Fcr09/CPU_MIPS/fpga_single_cycle/fpga_single_cycle.runs/impl_1/usage_statistics_webtalk.html

### Device Usage Page (usage_statistics_webtalk.html)

This HTML page displays the device usage statistics that will be sent to Xilinx.
To see the actual file transmitted to Xilinx, please click here.

software_version_and_target_device
beta | FALSE | build_version | 3064766
date_generated | Mon Sep 12 18:46:56 2022 | os_platform | WIN64
product_version | Vivado v2020.2 (64-bit) | project_id | 06335934545b4817ba23d04142ba414c
project_iteration | 2 | random_id | 32a24ede3cdd5bcc840593bf387105b8
registration_id | 32a24ede3cdd5bcc840593bf387105b8 | route_design | TRUE
target_device | xc7a100t | target_family | artix7
target_package | csg324 | target_speed | -1
tool_flow | Vivado

user_environment
cpu_name | Intel(R) Core(TM) i7-10510U CPU @ 1.80GHz | cpu_speed | 2304 MHz
os_name | Windows Server 2016 or Windows 10 | os_release | major release (build 9200)
system_ram | 17.000 GB | total_processors | 1

vivado_usage

gui_handlers
basedialog_cancel=1 | basedialog_ok=18 | exploreaheadview_launch_selected_runs=2 | expruntreepanel_exp_run_tree_table=4
filesetpanel_file_set_panel_tree=15 | flownavigatortreepanel_flow_navigator_tree=12 | htree_collapse_all=1 | msgview_information_messages=1
netlisttreeview_netlist_tree=24 | pacommandnames_auto_connect_target=2 | pacommandnames_run_bitgen=2 | pacommandnames_schematic=4
pacommandnames_select_area=1 | pacommandnames_simulation_live_run=2 | pacommandnames_simulation_run_behavioral=1 | pacommandnames_zoom_fit=1
paviews_device=1 | paviews_project_summary=3 | paviews_schematic=2 | programdebugtab_open_target=2
programdebugtab_program_device=3 | programdebugtab_refresh_device=1 | programfpgadialog_program=3 | progressdialog_cancel=1
projecttab_close_design=1 | rdiviews_waveform_viewer=1 | syntheticagettingstartedview_recent_projects=1 | syntheticastatemonitor_cancel=2

taskbanner_close=3

java_command_handlers
autoconnecttarget=2 | launchprogramfpga=3 | openhardwaremanager=2 | refreshdevice=1
runbitgen=2 | runimplementation=3 | runschematic=6 | runsynthesis=5
simulationrun=1 | simulationrunfortime=2 | toggleselectareamode=1 | viewtasksynthesis=1

zoomfit=1

other_data

guimode=1

project_data
constraintsetcount=1 | core_container=false | currentimplrun=impl_1 | currentsynthesisrun=synth_1
default_library=xil_defaultlib | designmode=RTL | export_simulation_activehdl=0 | export_simulation_ies=0
export_simulation_modelsim=0 | export_simulation_questa=0 | export_simulation_riviera=0 | export_simulation_vcs=0
export_simulation_xsim=0 | implstrategy=Vivado Implementation Defaults | launch_simulation_activehdl=0 | launch_simulation_ies=0
launch_simulation_modelsim=0 | launch_simulation_questa=0 | launch_simulation_riviera=0 | launch_simulation_vcs=0
launch_simulation_xsim=74 | simulator_language=Verilog | srcsetcount=33 | synthesisstrategy=Vivado Synthesis Defaults
target_language=Verilog | target_simulator=XSim | totalimplruns=1 | totalsynthesisruns=1

unisim_transformation

post_unisim_transformation
bufg=2 | carry4=391 | dsp48e1=3 | fdce=64
fdre=32841 | gnd=11 | ibuf=3 | lut1=106
lut2=762 | lut3=7969 | lut4=3082 | lut5=2047
lut6=50243 | muxf7=4414 | muxf8=2185 | obuf=16
ramd32=72 | rams32=24 | vcc=7

pre_unisim_transformation
bufg=2 | carry4=391 | dsp48e1=3 | fdce=64
fdre=32841 | gnd=11 | ibuf=3 | lut1=106
lut2=762 | lut3=7969 | lut4=3082 | lut5=2047
lut6=50243 | muxf7=4414 | muxf8=2185 | obuf=16
ram32m=12 | vcc=7

phys_opt_design_post_place

command_line_options
-aggressive_hold_fix=default::[not_specified] | -bram_register_opt=default::[not_specified] | -clock_opt=default::[not_specified] | -critical_cell_opt=default::[not_specified]
-critical_pin_opt=default::[not_specified] | -directive=default::[not_specified] | -dsp_register_opt=default::[not_specified] | -effort_level=default::[not_specified]
-fanout_opt=default::[not_specified] | -hold_fix=default::[not_specified] | -insert_negative_edge_ffs=default::[not_specified] | -multi_clock_opt=default::[not_specified]
-placement_opt=default::[not_specified] | -restruct_opt=default::[not_specified] | -retime=default::[not_specified] | -rewire=default::[not_specified]
-shift_register_opt=default::[not_specified] | -uram_register_opt=default::[not_specified] | -verbose=default::[not_specified] | -vhfn=default::[not_specified]

report_drc

command_line_options
-append=default::[not_specified] | -checks=default::[not_specified] | -fail_on=default::[not_specified] | -force=default::[not_specified]
-format=default::[not_specified] | -internal=default::[not_specified] | -internal_only=default::[not_specified] | -max_msgs_per_check=default::[not_specified]
-messages=default::[not_specified] | -name=default::[not_specified] | -no_waivers=default::[not_specified] | -return_string=default::[not_specified]
-ruledecks=default::[not_specified] | -upgrade_cw=default::[not_specified] | -waived=default::[not_specified]

results
cfgbvs-1=1 | dpip-1=6 | dpop-1=3 | dpop-2=3

report_utilization

clocking
bufgctrl_available=32 | bufgctrl_fixed=0 | bufgctrl_used=3 | bufgctrl_util_percentage=9.38
bufhce_available=96 | bufhce_fixed=0 | bufhce_used=0 | bufhce_util_percentage=0.00
bufio_available=24 | bufio_fixed=0 | bufio_used=0 | bufio_util_percentage=0.00
bufmrce_available=12 | bufmrce_fixed=0 | bufmrce_used=0 | bufmrce_util_percentage=0.00
bufr_available=24 | bufr_fixed=0 | bufr_used=0 | bufr_util_percentage=0.00
mmcme2_adv_available=6 | mmcme2_adv_fixed=0 | mmcme2_adv_used=0 | mmcme2_adv_util_percentage=0.00
plle2_adv_available=6 | plle2_adv_fixed=0 | plle2_adv_used=0 | plle2_adv_util_percentage=0.00

dsp
dsp48e1_only_used=3 | dsps_available=240 | dsps_fixed=0 | dsps_used=3

dsps_util_percentage=1.25

io_standard
blvds_25=0 | diff_hstl_i=0 | diff_hstl_i_18=0 | diff_hstl_ii=0
diff_hstl_ii_18=0 | diff_hsul_12=0 | diff_mobile_ddr=0 | diff_sstl135=0
diff_sstl135_r=0 | diff_sstl15=0 | diff_sstl15_r=0 | diff_sstl18_i=0
diff_sstl18_ii=0 | hstl_i=0 | hstl_i_18=0 | hstl_ii=0
hstl_ii_18=0 | hsul_12=0 | lvcmos12=0 | lvcmos15=0
lvcmos18=0 | lvcmos25=0 | lvcmos33=1 | lvds_25=0
lvttl=0 | mini_lvds_25=0 | mobile_ddr=0 | pci33_3=0
ppds_25=0 | rsds_25=0 | sstl135=0 | sstl135_r=0
sstl15=0 | sstl15_r=0 | sstl18_i=0 | sstl18_ii=0

tmds_33=0

memory
block_ram_tile_available=135 | block_ram_tile_fixed=0 | block_ram_tile_used=0 | block_ram_tile_util_percentage=0.00
ramb18_available=270 | ramb18_fixed=0 | ramb18_used=0 | ramb18_util_percentage=0.00
ramb36_fifo_available=135 | ramb36_fifo_fixed=0 | ramb36_fifo_used=0 | ramb36_fifo_util_percentage=0.00

primitives
bufg_functional_category=Clock | bufg_used=3 | carry4_functional_category=CarryLogic | carry4_used=391
dsp48e1_functional_category=Block Arithmetic | dsp48e1_used=3 | fdce_functional_category=Flop & Latch | fdce_used=64
fdre_functional_category=Flop & Latch | fdre_used=32841 | ibuf_functional_category=IO | ibuf_used=3
lut1_functional_category=LUT | lut1_used=102 | lut2_functional_category=LUT | lut2_used=762
lut3_functional_category=LUT | lut3_used=7968 | lut4_functional_category=LUT | lut4_used=3082
lut5_functional_category=LUT | lut5_used=2047 | lut6_functional_category=LUT | lut6_used=50243
muxf7_functional_category=MuxFx | muxf7_used=4414 | muxf8_functional_category=MuxFx | muxf8_used=2185
obuf_functional_category=IO | obuf_used=16 | ramd32_functional_category=Distributed Memory | ramd32_used=72
rams32_functional_category=Distributed Memory | rams32_used=24

slice_logic
f7_muxes_available=31700 | f7_muxes_fixed=0 | f7_muxes_used=4414 | f7_muxes_util_percentage=13.92
f8_muxes_available=15850 | f8_muxes_fixed=0 | f8_muxes_used=2185 | f8_muxes_util_percentage=13.79
lut_as_distributed_ram_fixed=0 | lut_as_distributed_ram_used=48 | lut_as_logic_available=63400 | lut_as_logic_fixed=0
lut_as_logic_used=58330 | lut_as_logic_util_percentage=92.00 | lut_as_memory_available=19000 | lut_as_memory_fixed=0
lut_as_memory_used=48 | lut_as_memory_util_percentage=0.25 | lut_as_shift_register_fixed=0 | lut_as_shift_register_used=0
register_as_flip_flop_available=126800 | register_as_flip_flop_fixed=0 | register_as_flip_flop_used=32905 | register_as_flip_flop_util_percentage=25.95
register_as_latch_available=126800 | register_as_latch_fixed=0 | register_as_latch_used=0 | register_as_latch_util_percentage=0.00
slice_luts_available=63400 | slice_luts_fixed=0 | slice_luts_used=58378 | slice_luts_util_percentage=92.08
slice_registers_available=126800 | slice_registers_fixed=0 | slice_registers_used=32905 | slice_registers_util_percentage=25.95
lut_as_distributed_ram_fixed=0 | lut_as_distributed_ram_used=48 | lut_as_logic_available=63400 | lut_as_logic_fixed=0
lut_as_logic_used=58330 | lut_as_logic_util_percentage=92.00 | lut_as_memory_available=19000 | lut_as_memory_fixed=0
lut_as_memory_used=48 | lut_as_memory_util_percentage=0.25 | lut_as_shift_register_fixed=0 | lut_as_shift_register_used=0
lut_in_front_of_the_register_is_unused_fixed=0 | lut_in_front_of_the_register_is_unused_used=9 | lut_in_front_of_the_register_is_used_fixed=9 | lut_in_front_of_the_register_is_used_used=27
register_driven_from_outside_the_slice_fixed=27 | register_driven_from_outside_the_slice_used=36 | register_driven_from_within_the_slice_fixed=36 | register_driven_from_within_the_slice_used=32869
slice_available=15850 | slice_fixed=0 | slice_registers_available=126800 | slice_registers_fixed=0
slice_registers_used=32905 | slice_registers_util_percentage=25.95 | slice_used=15719 | slice_util_percentage=99.17
slicel_fixed=0 | slicel_used=10995 | slicem_fixed=0 | slicem_used=4724
unique_control_sets_available=15850 | unique_control_sets_fixed=15850 | unique_control_sets_used=8 | unique_control_sets_util_percentage=0.05
using_o5_and_o6_fixed=0.05 | using_o5_and_o6_used=48 | using_o5_output_only_fixed=48 | using_o5_output_only_used=0
using_o6_output_only_fixed=0 | using_o6_output_only_used=0

specific_feature
bscane2_available=4 | bscane2_fixed=0 | bscane2_used=0 | bscane2_util_percentage=0.00
capturee2_available=1 | capturee2_fixed=0 | capturee2_used=0 | capturee2_util_percentage=0.00
dna_port_available=1 | dna_port_fixed=0 | dna_port_used=0 | dna_port_util_percentage=0.00
efuse_usr_available=1 | efuse_usr_fixed=0 | efuse_usr_used=0 | efuse_usr_util_percentage=0.00
frame_ecce2_available=1 | frame_ecce2_fixed=0 | frame_ecce2_used=0 | frame_ecce2_util_percentage=0.00
icape2_available=2 | icape2_fixed=0 | icape2_used=0 | icape2_util_percentage=0.00
pcie_2_1_available=1 | pcie_2_1_fixed=0 | pcie_2_1_used=0 | pcie_2_1_util_percentage=0.00
startupe2_available=1 | startupe2_fixed=0 | startupe2_used=0 | startupe2_util_percentage=0.00
xadc_available=1 | xadc_fixed=0 | xadc_used=0 | xadc_util_percentage=0.00

synthesis

command_line_options
-assert=default::[not_specified] | -bufg=default::12 | -cascade_dsp=default::auto | -constrset=default::[not_specified]
-control_set_opt_threshold=default::auto | -debug_log=default::[not_specified] | -directive=default::default | -fanout_limit=default::10000
-flatten_hierarchy=default::rebuilt | -fsm_extraction=default::auto | -gated_clock_conversion=default::off | -generic=default::[not_specified]
-include_dirs=default::[not_specified] | -keep_equivalent_registers=default::[not_specified] | -lint=default::[not_specified] | -max_bram=default::-1
-max_bram_cascade_height=default::-1 | -max_dsp=default::-1 | -max_uram=default::-1 | -max_uram_cascade_height=default::-1
-mode=default::default | -name=default::[not_specified] | -no_lc=default::[not_specified] | -no_srlextract=default::[not_specified]
-no_timing_driven=default::[not_specified] | -os=default::[not_specified] | -part=xc7a100tcsg324-1 | -resource_sharing=default::auto
-retiming=default::[not_specified] | -rtl=default::[not_specified] | -rtl_skip_constraints=default::[not_specified] | -rtl_skip_ip=default::[not_specified]
-seu_protect=default::none | -sfcu=default::[not_specified] | -shreg_min_size=default::3 | -top=single_cycle

-verilog_define=default::[not_specified]

usage
elapsed=00:20:28s | hls_ip=0 | memory_gain=1362.992MB | memory_peak=2379.836MB

xsim

command_line_options
-sim_mode=default::behavioral | -sim_type=default::
