Fcr09/CPU_MIPS/(list of files, drawings)

Other design files:
cpu21-riscv.circ
