Fcr09/CPU_MIPS/fpga_single_cycle/fpga_single_cycle.srcs/sources_1/imports/hardwire_controller/verilog/circuit/alu_controller.v

/******************************************************************************
 ** Logisim goes FPGA automatic generated Verilog code                       **
 **                                                                          **
 ** Component : alu_controller                                               **
 **                                                                          **
 ******************************************************************************/

`timescale 1ns/1ps
module alu_controller( F12,
                       F13,
                       F14,
                       F25,
                       F30,
                       OP2,
                       OP3,
                       OP4,
                       OP5,
                       OP6,
                       S0,
                       S1,
                       S2,
                       S3);

   /***************************************************************************
    ** Here the inputs are defined                                           **
    ***************************************************************************/
   input  F12;
   input  F13;
   input  F14;
   input  F25;
   input  F30;
   input  OP2;
   input  OP3;
   input  OP4;
   input  OP5;
   input  OP6;

   /***************************************************************************
    ** Here the outputs are defined                                          **
    ***************************************************************************/
   output S0;
   output S1;
   output S2;
   output S3;

   /***************************************************************************
    ** Here the internal wires are defined                                   **
    ***************************************************************************/
   wire s_LOGISIM_NET_0;
   wire s_LOGISIM_NET_1;
   wire s_LOGISIM_NET_10;
   wire s_LOGISIM_NET_100;
   wire s_LOGISIM_NET_101;
   wire s_LOGISIM_NET_102;
   wire s_LOGISIM_NET_103;
   wire s_LOGISIM_NET_104;
   wire s_LOGISIM_NET_105;
   wire s_LOGISIM_NET_106;
   wire s_LOGISIM_NET_107;
   wire s_LOGISIM_NET_108;
   wire s_LOGISIM_NET_109;
   wire s_LOGISIM_NET_11;
   wire s_LOGISIM_NET_110;
   wire s_LOGISIM_NET_111;
   wire s_LOGISIM_NET_112;
   wire s_LOGISIM_NET_113;
   wire s_LOGISIM_NET_114;
   wire s_LOGISIM_NET_115;
   wire s_LOGISIM_NET_116;
   wire s_LOGISIM_NET_117;
   wire s_LOGISIM_NET_118;
   wire s_LOGISIM_NET_119;
   wire s_LOGISIM_NET_12;
   wire s_LOGISIM_NET_120;
   wire s_LOGISIM_NET_121;
   wire s_LOGISIM_NET_122;
   wire s_LOGISIM_NET_123;
   wire s_LOGISIM_NET_124;
   wire s_LOGISIM_NET_125;
   wire s_LOGISIM_NET_126;
   wire s_LOGISIM_NET_127;
   wire s_LOGISIM_NET_128;
   wire s_LOGISIM_NET_129;
   wire s_LOGISIM_NET_13;
   wire s_LOGISIM_NET_130;
   wire s_LOGISIM_NET_131;
   wire s_LOGISIM_NET_132;
   wire s_LOGISIM_NET_133;
   wire s_LOGISIM_NET_134;
   wire s_LOGISIM_NET_135;
   wire s_LOGISIM_NET_136;
   wire s_LOGISIM_NET_137;
   wire s_LOGISIM_NET_138;
   wire s_LOGISIM_NET_139;
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
                .Result(s_LOGISIM_NET_38));

   NOT_GATE      GATE_260 (.Input_1(s_LOGISIM_NET_25),
                           .Result(s_LOGISIM_NET_21));

   NOT_GATE      GATE_261 (.Input_1(s_LOGISIM_NET_11),
                           .Result(s_LOGISIM_NET_15));

   NOT_GATE      GATE_262 (.Input_1(s_LOGISIM_NET_13),
                           .Result(s_LOGISIM_NET_65));

   NOT_GATE      GATE_263 (.Input_1(s_LOGISIM_NET_25),
                           .Result(s_LOGISIM_NET_213));



endmodule
