Fcr09/CPU_MIPS/fpga_single_cycle/fpga_single_cycle.srcs/sources_1/imports/hardwire_controller/verilog/circuit/signal_controller.v

/******************************************************************************
 ** Logisim goes FPGA automatic generated Verilog code                       **
 **                                                                          **
 ** Component : signal_controller                                            **
 **                                                                          **
 ******************************************************************************/

`timescale 1ns/1ps
module signal_controller( F12,
                          F13,
                          F14,
                          F25,
                          F30,
                          OP2,
                          OP3,
                          OP4,
                          OP5,
                          OP6,
                          ALU_Src,
                          BEQ,
                          BGEU,
                          BNE,
                          CSRRCI,
                          CSRRSI,
                          Jal,
                          LUI,
                          MemToReg,
                          MemWrite,
                          RegWrite,
                          SB,
                          S_Type,
                          URET,
                          ecall,
                          jalr);

   /***************************************************************************
    ** Here the inputs are defined                                           **
    ***************************************************************************/
   input  F12;
   input  F13;
   input  F14;
   input  F25;
   input  F30;
   input  OP2;
   input  OP3;
   input  OP4;
   input  OP5;
   input  OP6;

   /***************************************************************************
    ** Here the outputs are defined                                          **
    ***************************************************************************/
   output ALU_Src;
   output BEQ;
   output BGEU;
   output BNE;
   output CSRRCI;
   output CSRRSI;
   output Jal;
   output LUI;
   output MemToReg;
   output MemWrite;
   output RegWrite;
   output SB;
   output S_Type;
   output URET;
   output ecall;
   output jalr;

   /***************************************************************************
    ** Here the internal wires are defined                                   **
    ***************************************************************************/
   wire s_LOGISIM_NET_0;
   wire s_LOGISIM_NET_1;
   wire s_LOGISIM_NET_10;
   wire s_LOGISIM_NET_100;
   wire s_LOGISIM_NET_101;
   wire s_LOGISIM_NET_102;
   wire s_LOGISIM_NET_103;
   wire s_LOGISIM_NET_104;
   wire s_LOGISIM_NET_105;
   wire s_LOGISIM_NET_106;
   wire s_LOGISIM_NET_107;
   wire s_LOGISIM_NET_108;
   wire s_LOGISIM_NET_109;
   wire s_LOGISIM_NET_11;
   wire s_LOGISIM_NET_110;
   wire s_LOGISIM_NET_111;
   wire s_LOGISIM_NET_112;
   wire s_LOGISIM_NET_113;
   wire s_LOGISIM_NET_114;
   wire s_LOGISIM_NET_115;
   wire s_LOGISIM_NET_116;
   wire s_LOGISIM_NET_117;
   wire s_LOGISIM_NET_118;
   wire s_LOGISIM_NET_119;
   wire s_LOGISIM_NET_12;
   wire s_LOGISIM_NET_120;
   wire s_LOGISIM_NET_121;
   wire s_LOGISIM_NET_122;
   wire s_LOGISIM_NET_123;
   wire s_LOGISIM_NET_124;
   wire s_LOGISIM_NET_125;
   wire s_LOGISIM_NET_126;
   wire s_LOGISIM_NET_127;
   wire s_LOGISIM_NET_128;
   wire s_LOGISIM_NET_129;
   wire s_LOGISIM_NET_13;
   wire s_LOGISIM_NET_130;
   wire s_LOGISIM_NET_131;
   wire s_LOGISIM_NET_132;
   wire s_LOGISIM_NET_133;
   wire s_LOGISIM_NET_134;
   wire s_LOGISIM_NET_135;
   wire s_LOGISIM_NET_136;
   wire s_LOGISIM_NET_137;
   wire s_LOGISIM_NET_138;
   wire s_LOGISIM_NET_139;
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
   wire s_LOGISIM_NET_9;
   wire s_LOGISIM_NET_90;
   wire s_LOGISIM_NET_91;
   wire s_LOGISIM_NET_92;
   wire s_LOGISIM_NET_93;
   wire s_LOGISIM_NET_94;
   wire s_LOGISIM_NET_95;
   wire s_LOGISIM_NET_96;
   wire s_LOGISIM_NET_97;
   wire s_LOGISIM_NET_98;
   wire s_LOGISIM_NET_99;


   /***************************************************************************
    ** Here all input connections are defined                                **
    ***************************************************************************/
   assign s_LOGISIM_NET_34                   = F12;
   assign s_LOGISIM_NET_15                   = F13;
   assign s_LOGISIM_NET_32                   = F30;
   assign s_LOGISIM_NET_0                    = OP3;
   assign s_LOGISIM_NET_22                   = F14;
   assign s_LOGISIM_NET_25                   = OP6;
   assign s_LOGISIM_NET_18                   = OP2;
   assign s_LOGISIM_NET_2                    = OP5;
   assign s_LOGISIM_NET_8                    = F25;
   assign s_LOGISIM_NET_11                   = OP4;

   /***************************************************************************
    ** Here all output connections are defined                               **
    ***************************************************************************/
   assign BGEU                               = s_LOGISIM_NET_56;
   assign CSRRSI                             = s_LOGISIM_NET_230;
   assign Jal                                = s_LOGISIM_NET_180;
   assign MemWrite                           = s_LOGISIM_NET_133;
   assign RegWrite                           = s_LOGISIM_NET_314;
   assign SB                                 = s_LOGISIM_NET_305;
   assign URET                               = s_LOGISIM_NET_273;
   assign LUI                                = s_LOGISIM_NET_308;
   assign ALU_Src                            = s_LOGISIM_NET_113;
   assign MemToReg                           = s_LOGISIM_NET_131;
   assign BEQ                                = s_LOGISIM_NET_229;
   assign BNE                                = s_LOGISIM_NET_309;
   assign jalr                               = s_LOGISIM_NET_55;
   assign S_Type                             = s_LOGISIM_NET_194;
   assign ecall                              = s_LOGISIM_NET_288;
   assign CSRRCI                             = s_LOGISIM_NET_256;

   /***************************************************************************
    ** Here all normal components are defined                                **
    ***************************************************************************/
   NOT_GATE      GATE_1 (.Input_1(s_LOGISIM_NET_18),
                         .Result(s_LOGISIM_NET_258));

   AND_GATE_8_INPUTS #(.BubblesMask(0))
      GATE_2 (.Input_1(s_LOGISIM_NET_33),
              .Input_2(s_LOGISIM_NET_166),
              .Input_3(s_LOGISIM_NET_42),
              .Input_4(s_LOGISIM_NET_272),
              .Input_5(s_LOGISIM_NET_5),
              .Input_6(s_LOGISIM_NET_11),
              .Input_7(s_LOGISIM_NET_9),
              .Input_8(s_LOGISIM_NET_120),
              .Result(s_LOGISIM_NET_94));

   AND_GATE_8_INPUTS #(.BubblesMask(0))
      GATE_3 (.Input_1(s_LOGISIM_NET_22),
              .Input_2(s_LOGISIM_NET_74),
              .Input_3(s_LOGISIM_NET_198),
              .Input_4(s_LOGISIM_NET_307),
              .Input_5(s_LOGISIM_NET_206),
              .Input_6(s_LOGISIM_NET_11),
              .Input_7(s_LOGISIM_NET_123),
              .Input_8(s_LOGISIM_NET_258),
              .Result(s_LOGISIM_NET_274));

   NOT_GATE      GATE_4 (.Input_1(s_LOGISIM_NET_8),
                         .Result(s_LOGISIM_NET_29));

   NOT_GATE      GATE_5 (.Input_1(s_LOGISIM_NET_18),
                         .Result(s_LOGISIM_NET_192));

   NOT_GATE      GATE_6 (.Input_1(s_LOGISIM_NET_0),
                         .Result(s_LOGISIM_NET_92));

   AND_GATE_8_INPUTS #(.BubblesMask(0))
      GATE_7 (.Input_1(s_LOGISIM_NET_220),
              .Input_2(s_LOGISIM_NET_15),
              .Input_3(s_LOGISIM_NET_183),
              .Input_4(s_LOGISIM_NET_203),
              .Input_5(s_LOGISIM_NET_2),
              .Input_6(s_LOGISIM_NET_189),
              .Input_7(s_LOGISIM_NET_12),
              .Input_8(s_LOGISIM_NET_191),
              .Result(s_LOGISIM_NET_251));

   NOT_GATE      GATE_8 (.Input_1(s_LOGISIM_NET_22),
                         .Result(s_LOGISIM_NET_221));

   NOT_GATE      GATE_9 (.Input_1(s_LOGISIM_NET_0),
                         .Result(s_LOGISIM_NET_57));

   AND_GATE_5_INPUTS #(.BubblesMask(0))
      GATE_10 (.Input_1(s_LOGISIM_NET_25),
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
                           .Result(s_LOGISIM_NET_68));

   NOT_GATE      GATE_305 (.Input_1(s_LOGISIM_NET_22),
                           .Result(s_LOGISIM_NET_124));

   NOT_GATE      GATE_306 (.Input_1(s_LOGISIM_NET_0),
                           .Result(s_LOGISIM_NET_285));



endmodule
