Fcr09/CPU_MIPS/fpga_single_cycle/fpga_single_cycle.srcs/sources_1/imports/hardwire_controller/verilog/gates/OR_GATE_19_INPUTS.v

/******************************************************************************
 ** Logisim goes FPGA automatic generated Verilog code                       **
 **                                                                          **
 ** Component : OR_GATE_19_INPUTS                                            **
 **                                                                          **
 ******************************************************************************/

`timescale 1ns/1ps
module OR_GATE_19_INPUTS( Input_1,
                          Input_10,
                          Input_11,
                          Input_12,
                          Input_13,
                          Input_14,
                          Input_15,
                          Input_16,
                          Input_17,
                          Input_18,
                          Input_19,
                          Input_2,
                          Input_3,
                          Input_4,
                          Input_5,
                          Input_6,
                          Input_7,
                          Input_8,
                          Input_9,
                          Result);

   /***************************************************************************
    ** Here all module parameters are defined with a dummy value             **
    ***************************************************************************/
   parameter BubblesMask = 1;


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
   assign s_real_input_17 = (s_signal_invert_mask[16]) ? ~Input_17: Input_17;
   assign s_real_input_18 = (s_signal_invert_mask[17]) ? ~Input_18: Input_18;
   assign s_real_input_19 = (s_signal_invert_mask[18]) ? ~Input_19: Input_19;

   /***************************************************************************
    ** Here the functionality is defined                                     **
    ***************************************************************************/
   assign Result = s_real_input_1 |
                   s_real_input_2 |
                   s_real_input_3 |
                   s_real_input_4 |
                   s_real_input_5 |
                   s_real_input_6 |
                   s_real_input_7 |
                   s_real_input_8 |
                   s_real_input_9 |
                   s_real_input_10 |
                   s_real_input_11 |
                   s_real_input_12 |
                   s_real_input_13 |
                   s_real_input_14 |
                   s_real_input_15 |
                   s_real_input_16 |
                   s_real_input_17 |
                   s_real_input_18 |
                   s_real_input_19;


endmodule
