Fcr09/CPU_MIPS/fpga_single_cycle/fpga_single_cycle.srcs/sources_1/new/decode3_8.v

`timescale 1ns / 1ps
//////////////////////////////////////////////////////////////////////////////////
// Company: 
// Engineer: 
// 
// Create Date: 2022/05/09 20:28:11
// Design Name: 
// Module Name: decode3_8
// Project Name: 
// Target Devices: 
// Tool Versions: 
// Description: 
// 
// Dependencies: 
// 
// Revision:
// Revision 0.01 - File Created
// Additional Comments:
// 
//////////////////////////////////////////////////////////////////////////////////


module decode3_8(num,sel);
    input [2:0] num;
    output reg [7:0] sel;
    always@(num)begin
            case(num[2:0])
                3'b000:sel=8'b11111110;
                3'b001:sel=8'b11111101;
                3'b010:sel=8'b11111011;
                3'b011:sel=8'b11110111;
                3'b100:sel=8'b11101111;
                3'b101:sel=8'b11011111;
                3'b110:sel=8'b10111111;
                3'b111:sel=8'b01111111;
            endcase
    end
endmodule
