Fcr09/CPU_MIPS/fpga_single_cycle/fpga_single_cycle.srcs/sources_1/new/signed_ext.v

module signed_extend
(
    inmediate_data  ,
    extend_data   
);
    parameter N=12;
    input[N-1:0] inmediate_data;
    output[31:0] extend_data;
    assign extend_data={{{32-N}{inmediate_data[N-1]}},inmediate_data};
endmodule
